Tasnime1/Self-Balancing-Robot/Lilo/mpu6050.cpp

/************************************************************************************************
*            FILE: MPU6050.CPP
*          DRIVER: MPU6050
*     DESCRIPTION: Source file for all MPU6050-related functions declarations,
*                  Code from Jeff Rowberg's library; mpu6050.h
*
************************************************************************************************/


/*- INCLUDES
************************************************************************************************/
#include "mpu6050.h"
#include "I2Cdev.h"
#include "MPU6050_6Axis_MotionApps20.h"

#if I2CDEV_IMPLEMENTATION == I2CDEV_ARDUINO_WIRE
    #include "Wire.h"
#endif


/*- STATIC GLOBAL VARIABLES
************************************************************************************************/
MPU6050 mpu;

// MPU control/status vars
bool dmpReady = false;  // set true if DMP init was successful
uint8_t mpuIntStatus;   // holds actual interrupt status byte from MPU
uint8_t devStatus;      // return status after each device operation (0 = success, !0 = error)
uint16_t packetSize;    // expected DMP packet size (default is 42 bytes)
uint16_t fifoCount;     // count of all bytes currently in FIFO
uint8_t fifoBuffer[64]; // FIFO storage buffer

// orientation/motion vars
Quaternion q;           // [w, x, y, z]         quaternion container
VectorFloat gravity;    // [x, y, z]            gravity vector
float euler[3];         // [psi, theta, phi]    Euler angle container
float ypr[3];           // [yaw, pitch, roll]   yaw/pitch/roll container and gravity vector
volatile bool mpuInterrupt = false;     // indicates whether MPU interrupt pin has gone high


/*- ISR DECLARATION
************************************************************************************************/
void dmpDataReady()
{
    mpuInterrupt = true;
}


/*- FUNCTIONS' DECLARATION
************************************************************************************************/
void mpu_setup() {
  #if I2CDEV_IMPLEMENTATION == I2CDEV_ARDUINO_WIRE
        Wire.begin();
        TWBR=24;
        //Wire.setClock(400000); // 400kHz I2C clock. Comment this line if having compilation difficulties
    #elif I2CDEV_IMPLEMENTATION == I2CDEV_BUILTIN_FASTWIRE
        Fastwire::setup(400, true);
    #endif

  Serial.begin(115200);
  while (!Serial); // wait for Leonardo enumeration, others continue immediately

  // initialize device
  //Serial.println(F("Initializing I2C devices..."));
  mpu.initialize();
  pinMode(EXTERNAL_INTERRUPT0, INPUT);

  //  // wait for ready
  //   Serial.println(F("\nSend any character to begin DMP programming and demo: "));
  //   while (Serial.available() && Serial.read()); // empty buffer
  //   while (!Serial.available());                 // wait for data
  //   while (Serial.available() && Serial.read()); // empty buffer again

    // load and configure the DMP
    //Serial.println(F("Initializing DMP..."));
    devStatus = mpu.dmpInitialize();
    
    // supply your own gyro offsets here, scaled for min sensitivity
    //127	50	4 -1522	-130	1502	
    // 220 76 -85 1788
    
    mpu.setXGyroOffset(220);
    mpu.setYGyroOffset(46);
    mpu.setZGyroOffset(-85);
    //mpu.setXAccelOffset(-1522);
    //mpu.setYAccelOffset(-130);
    mpu.setZAccelOffset(1800);
    

    // make sure it worked (returns 0 if so)
    if (devStatus == 0) {
        // Calibration Time: generate offsets and calibrate our MPU6050
        //mpu.CalibrateAccel(6);
        //mpu.CalibrateGyro(6);
        //mpu.PrintActiveOffsets();
        // turn on the DMP, now that it's ready
        //Serial.println(F("Enabling DMP..."));
        mpu.setDMPEnabled(true);

        // enable ESP32 interrupt detection
        //Serial.print(F("Enabling interrupt detection (Arduino external interrupt "));
        //Serial.print(digitalPinToInterrupt(EXTERNAL_INTERRUPT0));
        //Serial.println(F(")..."));
        attachInterrupt(digitalPinToInterrupt(EXTERNAL_INTERRUPT0), dmpDataReady, RISING);
        mpuIntStatus = mpu.getIntStatus();

        // set our DMP Ready flag so the main loop() function knows it's okay to use it
        //Serial.println(F("DMP ready! Waiting for first interrupt..."));
        dmpReady = true;

        // get expected DMP packet size for later comparison
        packetSize = mpu.dmpGetFIFOPacketSize();
    } else {
        // ERROR!
        // 1 = initial memory load failed
        // 2 = DMP configuration updates failed
        // (if it's going to break, usually the code will be 1)
        Serial.print(F("DMP Initialization failed (code "));
        // Serial.print(devStatus);
        // Serial.println(F(")"));
    }

}


void mpu_update() {
   // if programming failed, don't try to do anything
    if (!dmpReady) return;
    // read a packet from FIFO
    if (mpu.dmpGetCurrentFIFOPacket(fifoBuffer)) { // Get the Latest packet 
            mpu.dmpGetQuaternion(&q, fifoBuffer);
            mpu.dmpGetEuler(euler, &q);
            mpu.dmpGetGravity(&gravity, &q);
            mpu.dmpGetYawPitchRoll(ypr, &q, &gravity);
    }
}


float return_pitch()
{
  return (ypr[1] * 180/M_PI + 180);
}
