Tasnime1/Self-Balancing-Robot/(commit log)

2022-12-14 Added correct MPU6050 offsets as well as best tunings so far
    [App.cpp, Lilo.ino, motors.cpp, motors.h, mpu6050.cpp, mpu6050.h, pid.cpp]
2022-12-19 tuning parameters again as I've added a PCB layer and so the robot's weight changed..
